Vcelari-Silicon-Hill/chytre-ulove-vahy/docs/Tenzometr_na_Load_Cell_2_Click.png

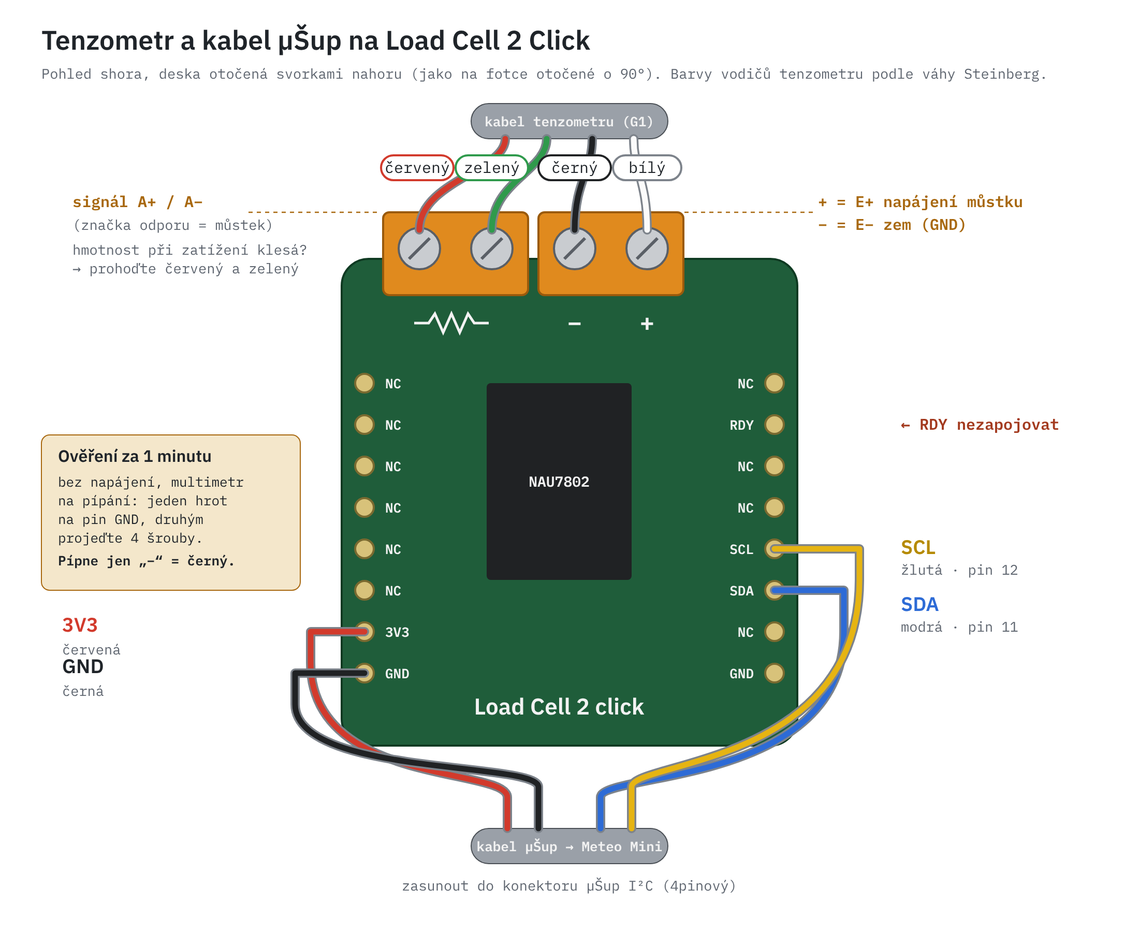
docs/Tenzometr_na_Load_Cell_2_Click.png
