Vcelari-Silicon-Hill/chytre-ulove-vahy/firmware/ulova_vaha/ulova_vaha.ino

// Chytré úly pro Silicon Hill – úlová váha
// The code lives in main.cpp, config.cpp, sensors.cpp, net.cpp and console.cpp.
// Arduino IDE: board "ESP32C3 Dev Module", USB CDC On Boot: Enabled.
// Libraries: SparkFun Qwiic Scale NAU7802, OneWire, DallasTemperature.
