Vcelari-Silicon-Hill/chytre-ulove-vahy/(commit log)

2026-11-11 Chytré úly pro Silicon Hill: firmware, server a veřejný přehled
    Firmware pro LaskaKit Meteo Mini (ESP32-C3 + NAU7802 + 2x DS18B20),
    server FastAPI + SQLite s veřejným přehledem, instalátor firmwaru
    v prohlížeči, montážní návod. Licence MIT.
    Claude-Session: https://claude.ai/code/session_01Hr34d6tQMZkwSLMbfzt726
2026-11-12 Wi-Fi diagnostics: disconnect reason, scan/networks command, show-password toggle
    Firmware 1.0.1 reports why the connection failed and lists the 2.4 GHz
    networks it sees; the installer explains the reason and runs the scan.
    Claude-Session: https://claude.ai/code/session_01Him6pgxQb4nncEDKzRhArp
    [config.h, console.cpp, net.cpp, net.h]
2026-11-12 firmware 1.0.2: tare and calibration read the load cell the same way as a measurement
    They took 32 samples after power-up while a measurement takes 16; the reading is
    still settling then, so the weight carried a constant offset after calibration.
    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
2026-11-13 firmware 1.0.3: work with a single thermometer; fall back to any sensor when the assigned ones are silent
    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
2026-11-13 firmware 1.0.4: internal pull-up on the 1-Wire pin as a fallback
    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
